almtzr/Pedro/img/kickstarter.png

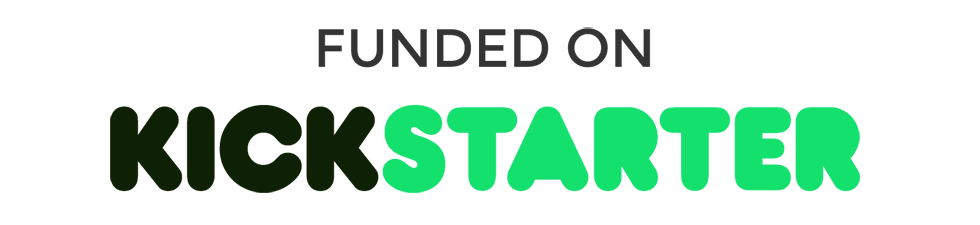
img/kickstarter.png
