almtzr/Pedro/img/pedro_2.03.png

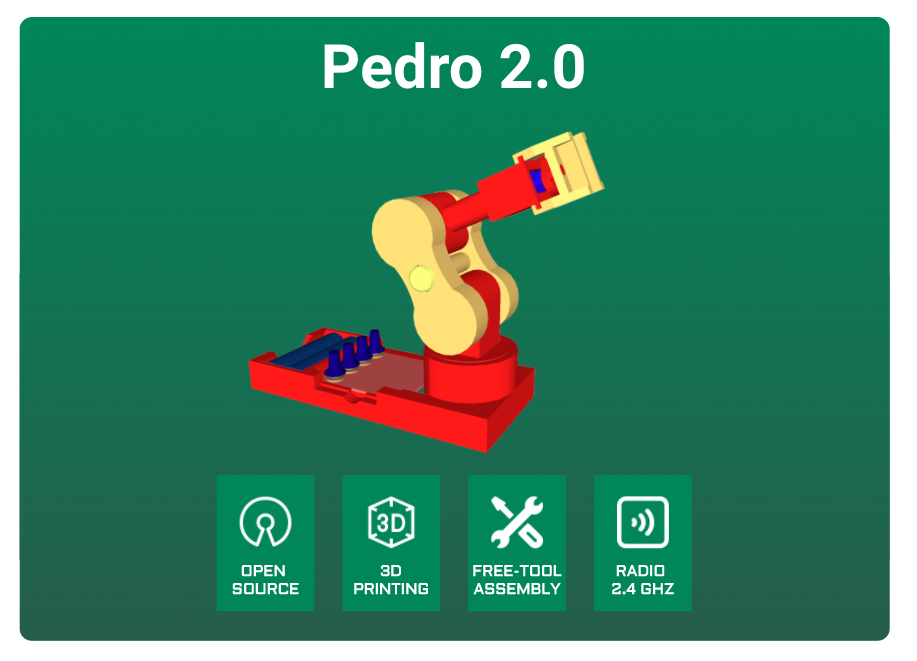
img/pedro_2.03.png
