almtzr/Pedro/img/pedro_kit.png

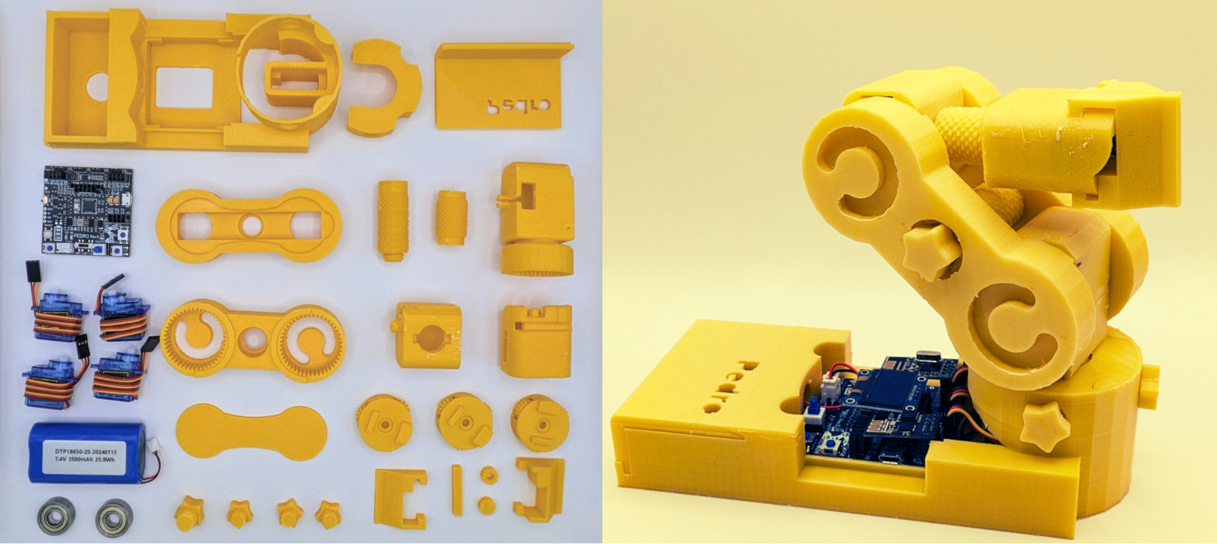
img/pedro_kit.png
