almtzr/Pedro/img/pedro_oshw.png

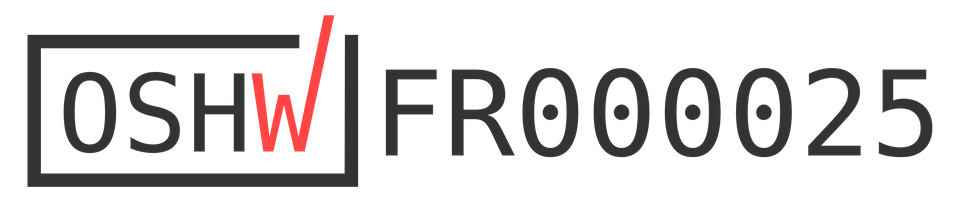
img/pedro_oshw.png
