almtzr/Pedro/img/vote_for_pedro.jpeg

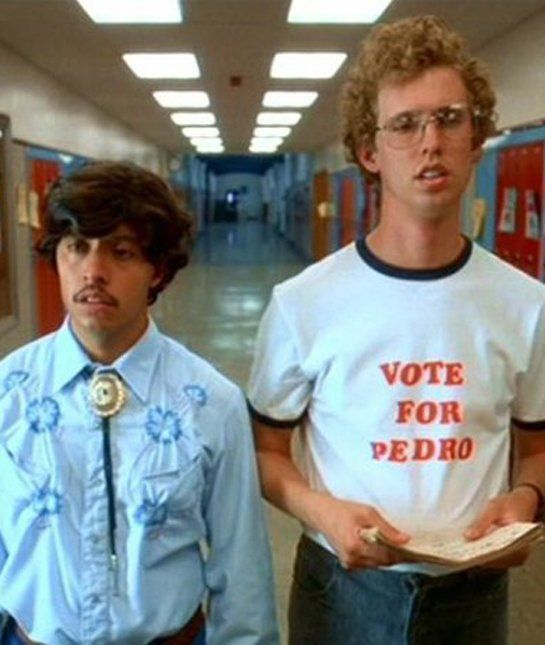
img/vote_for_pedro.jpeg
