almtzr/Pedro/img/workshop.jpg

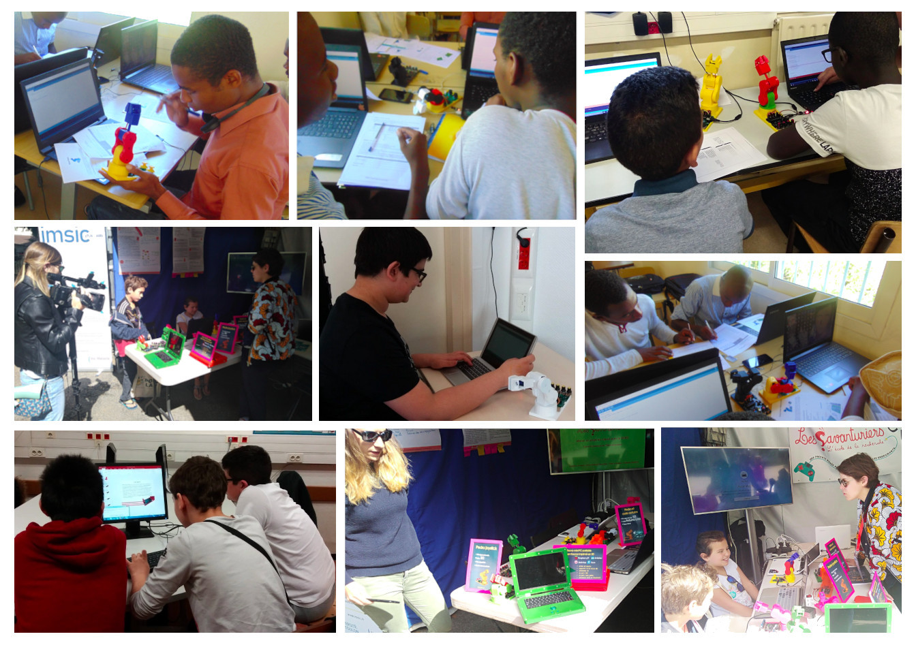
img/workshop.jpg
