almtzr/Pedro/img/wrkp-11.png

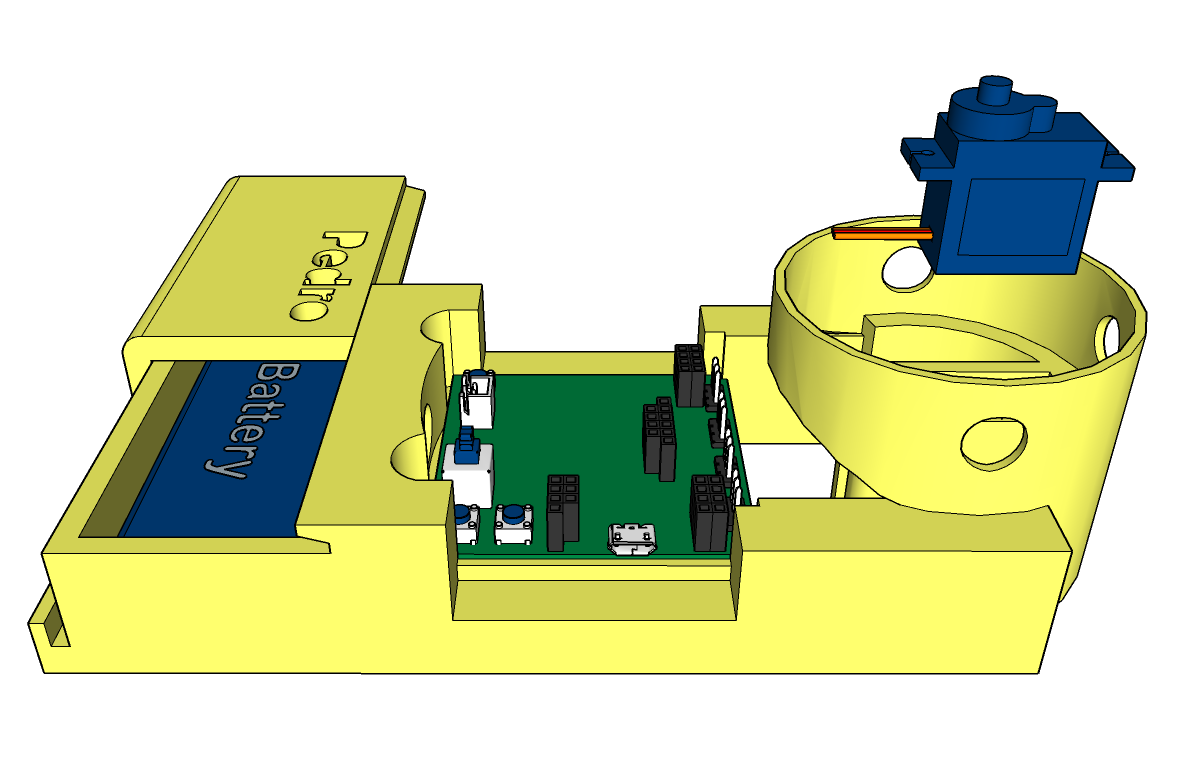
img/wrkp-11.png
