almtzr/Pedro/img/wrkp-12.png

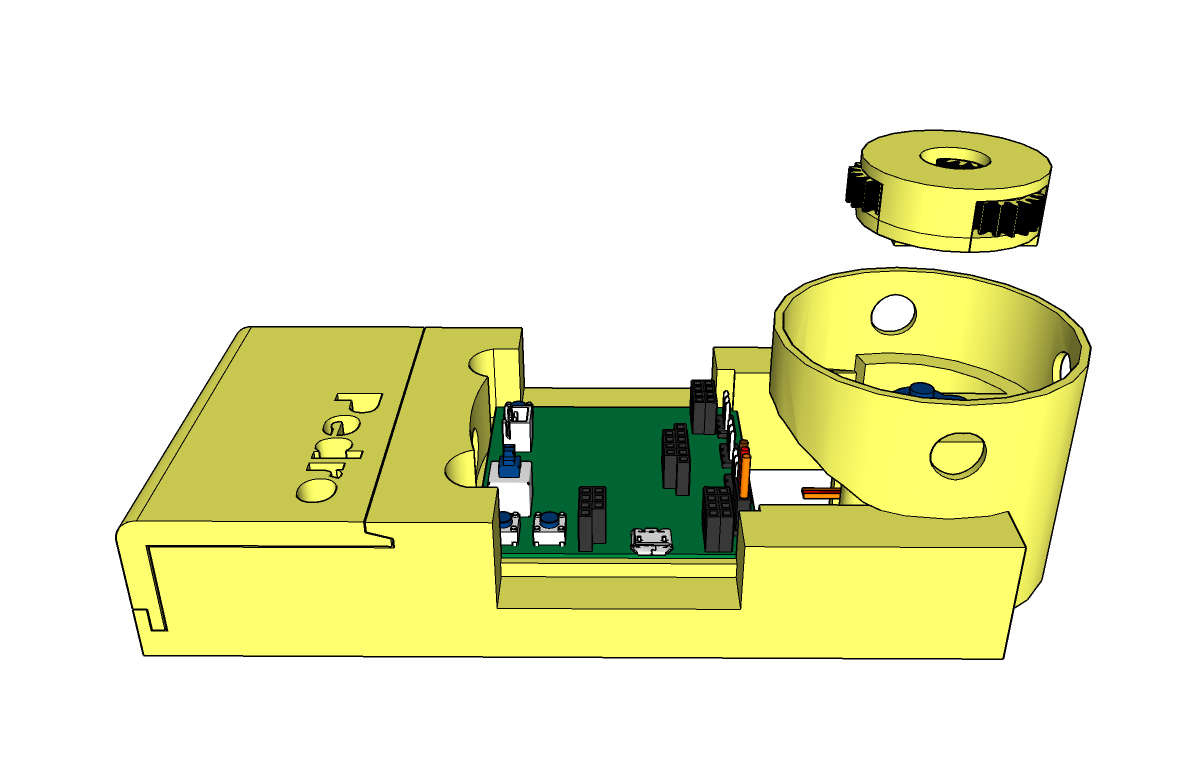
img/wrkp-12.png
