almtzr/Pedro/img/wrkp-13.png

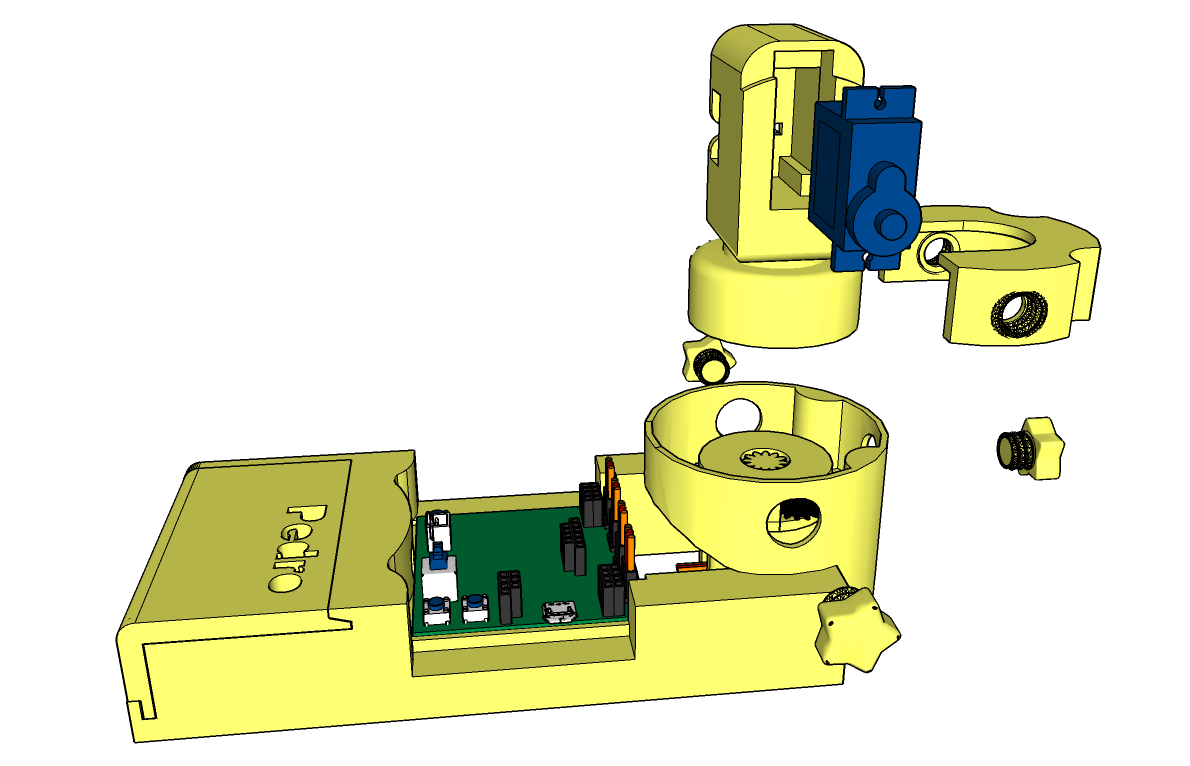
img/wrkp-13.png
