almtzr/Pedro/img/wrkp-14.png

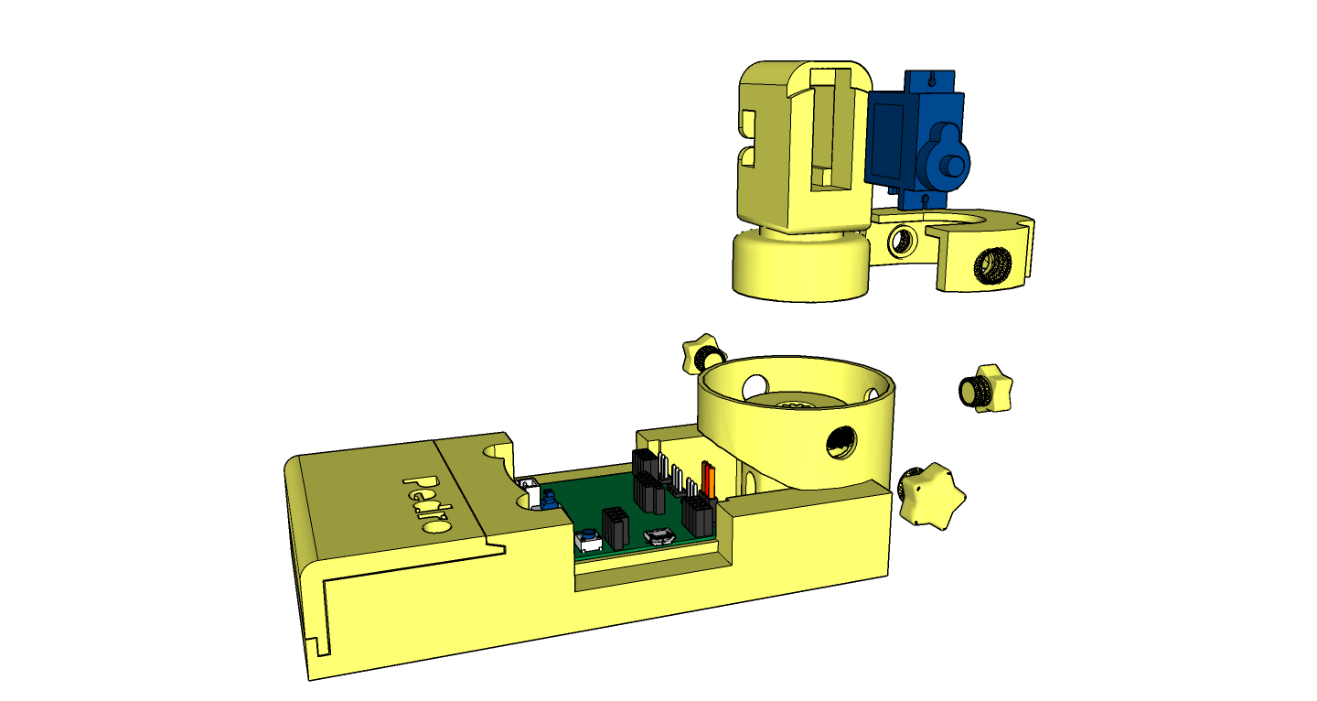
img/wrkp-14.png
