almtzr/Pedro/img/wrkp-15.png

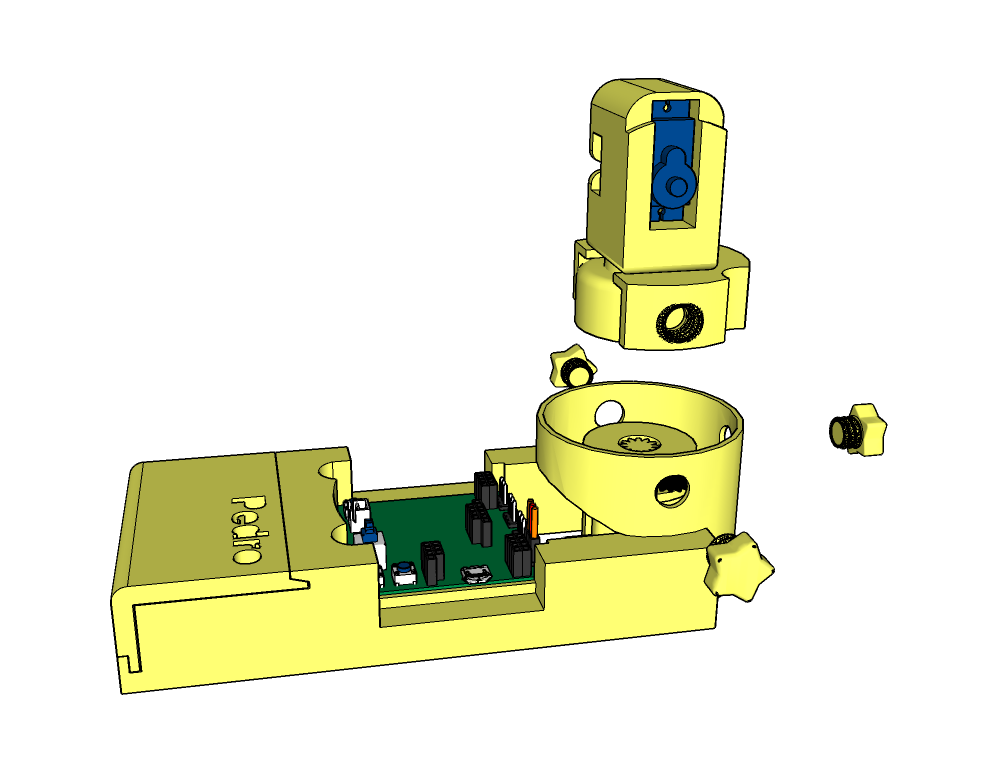
img/wrkp-15.png
