almtzr/Pedro/img/wrkp-16.png

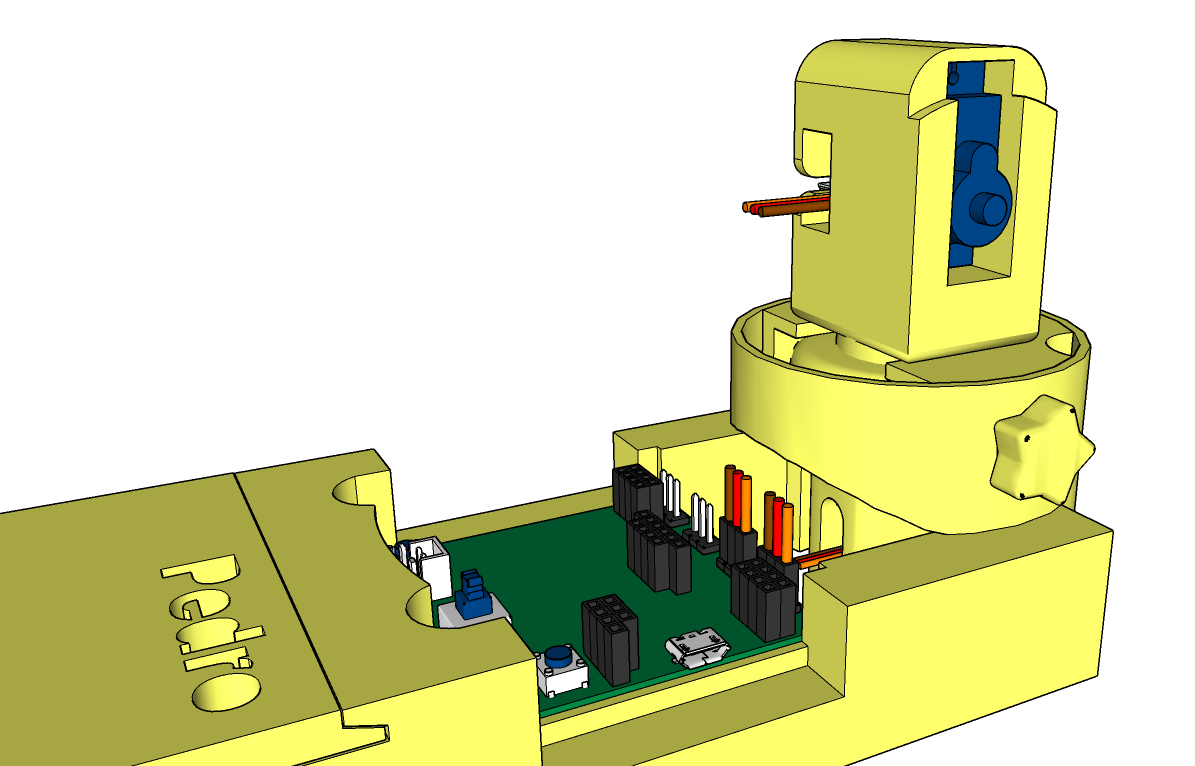
img/wrkp-16.png
