almtzr/Pedro/img/wrkp-21.png

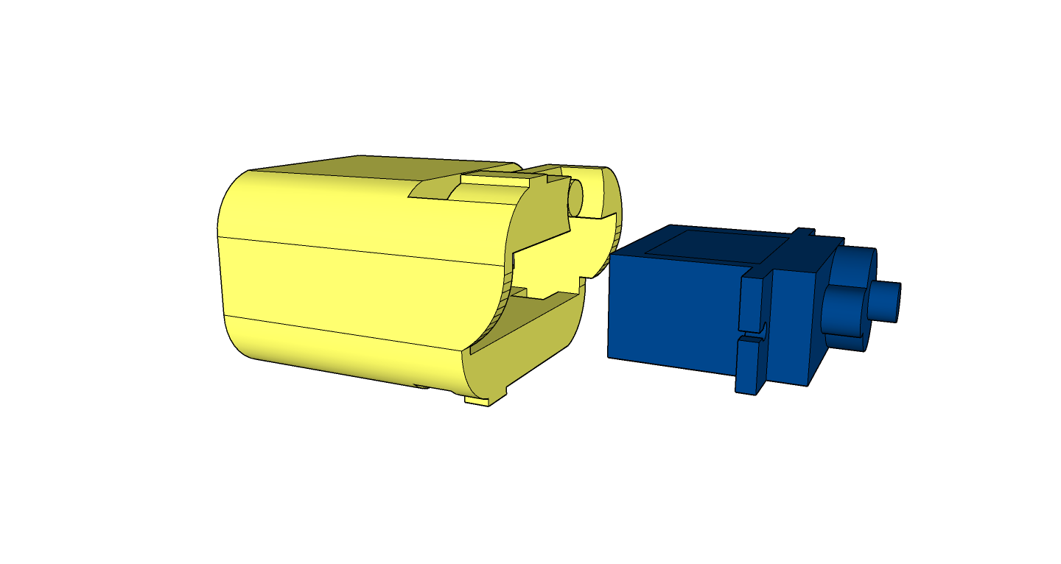
img/wrkp-21.png
