almtzr/Pedro/img/wrkp-22.png

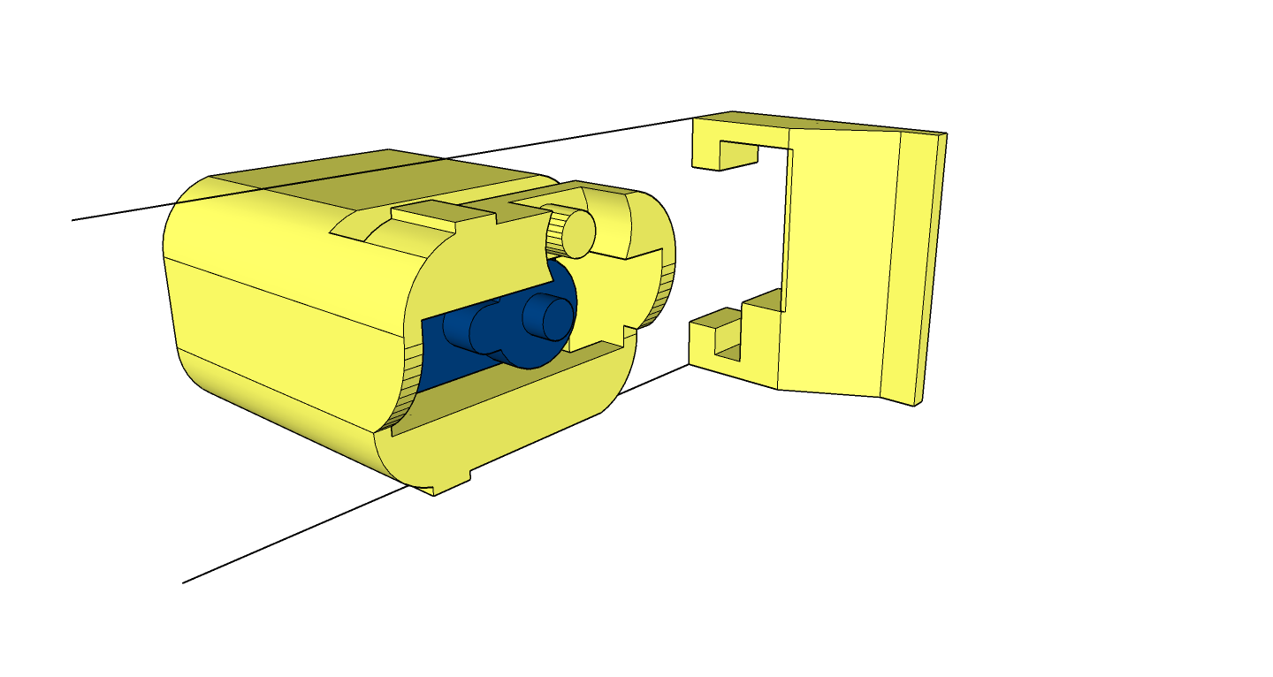
img/wrkp-22.png
