almtzr/Pedro/img/wrkp-23.png

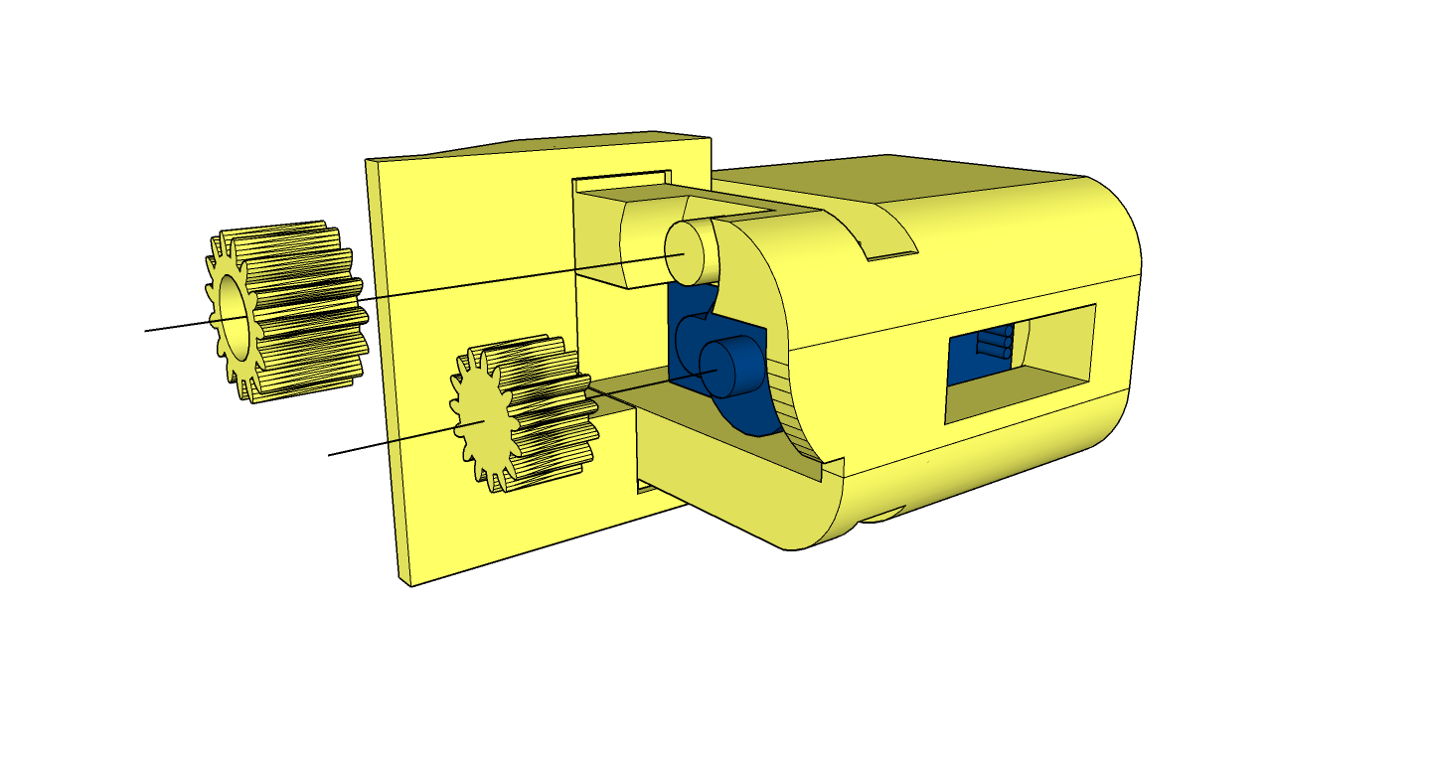
img/wrkp-23.png
