almtzr/Pedro/img/wrkp-24.png

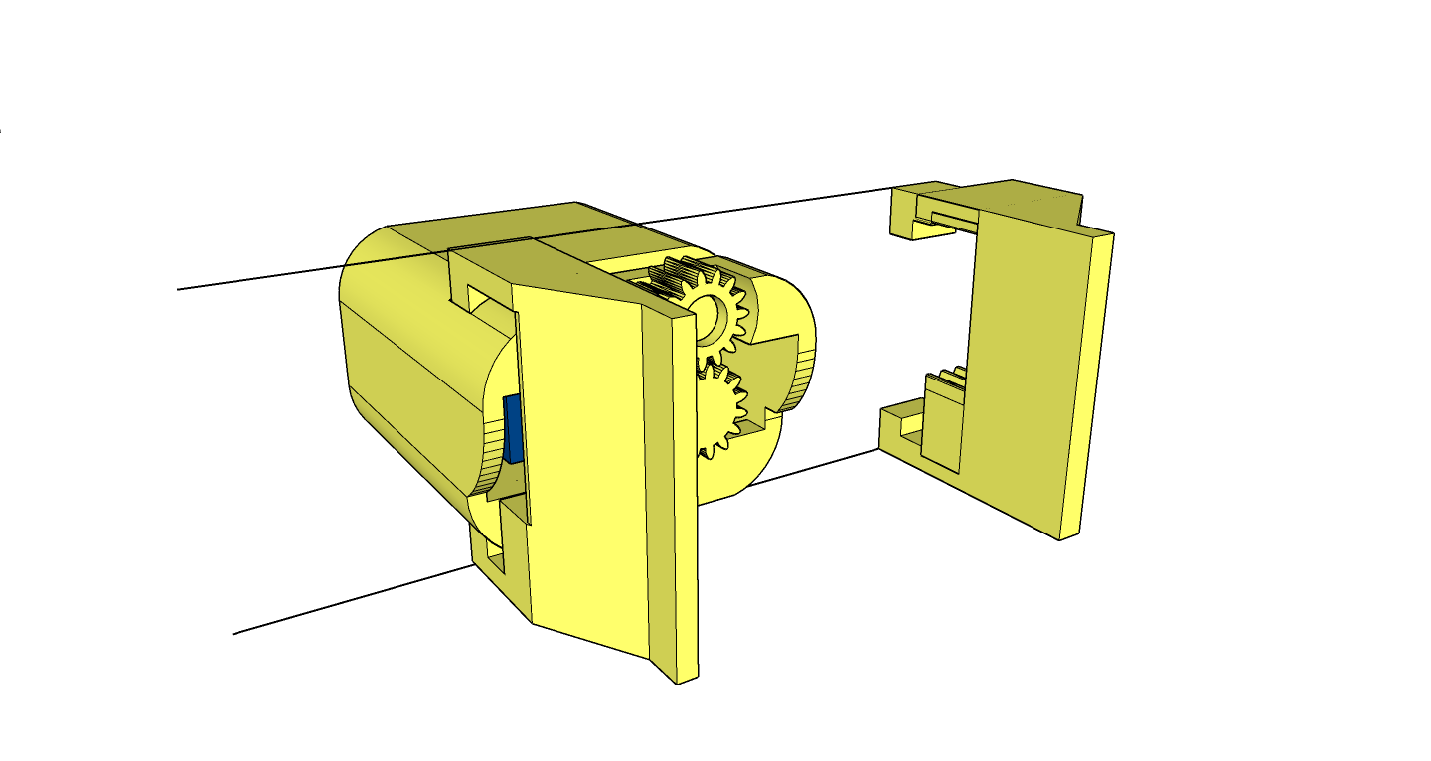
img/wrkp-24.png
