almtzr/Pedro/img/wrkp-25.png

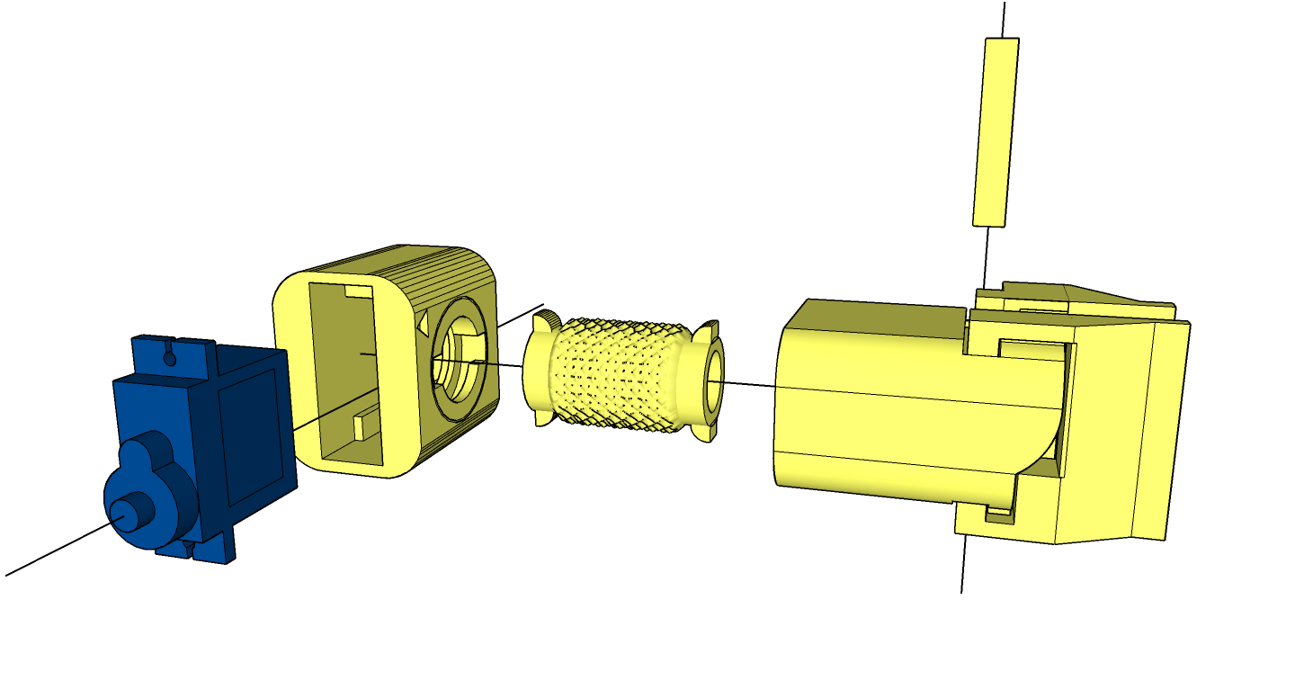
img/wrkp-25.png
