almtzr/Pedro/img/wrkp-26.png

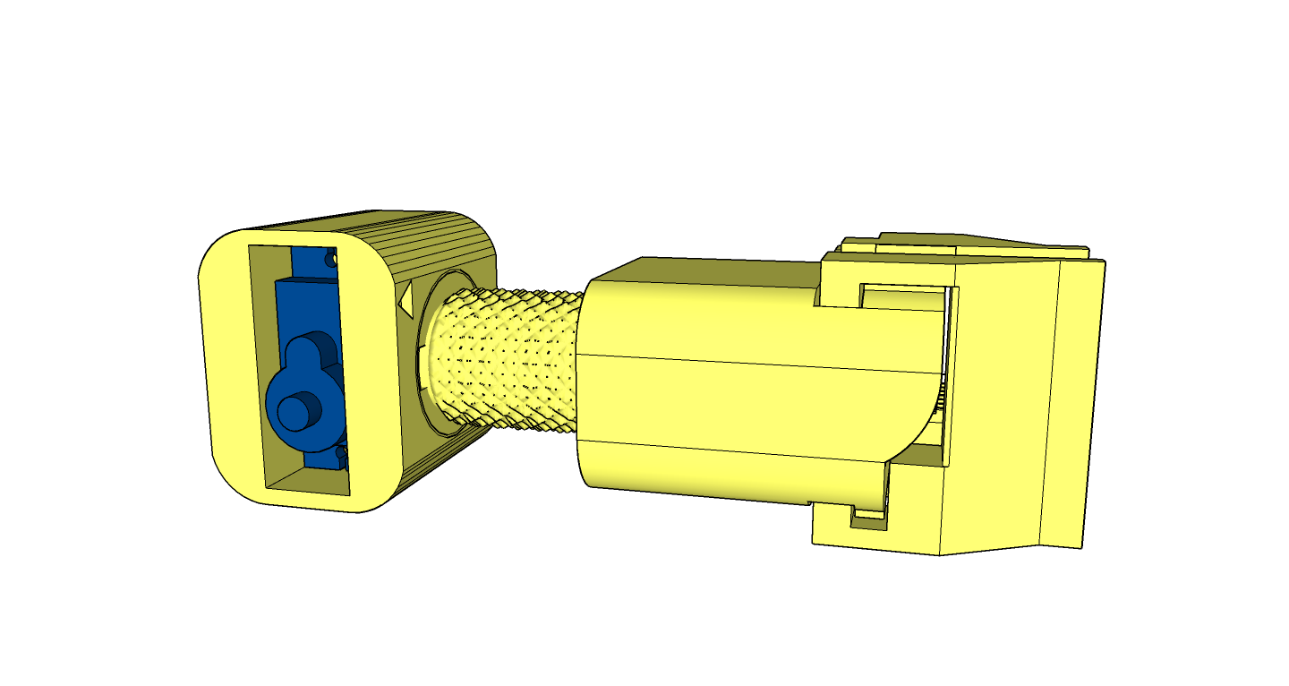
img/wrkp-26.png
