almtzr/Pedro/img/wrkp-27.png

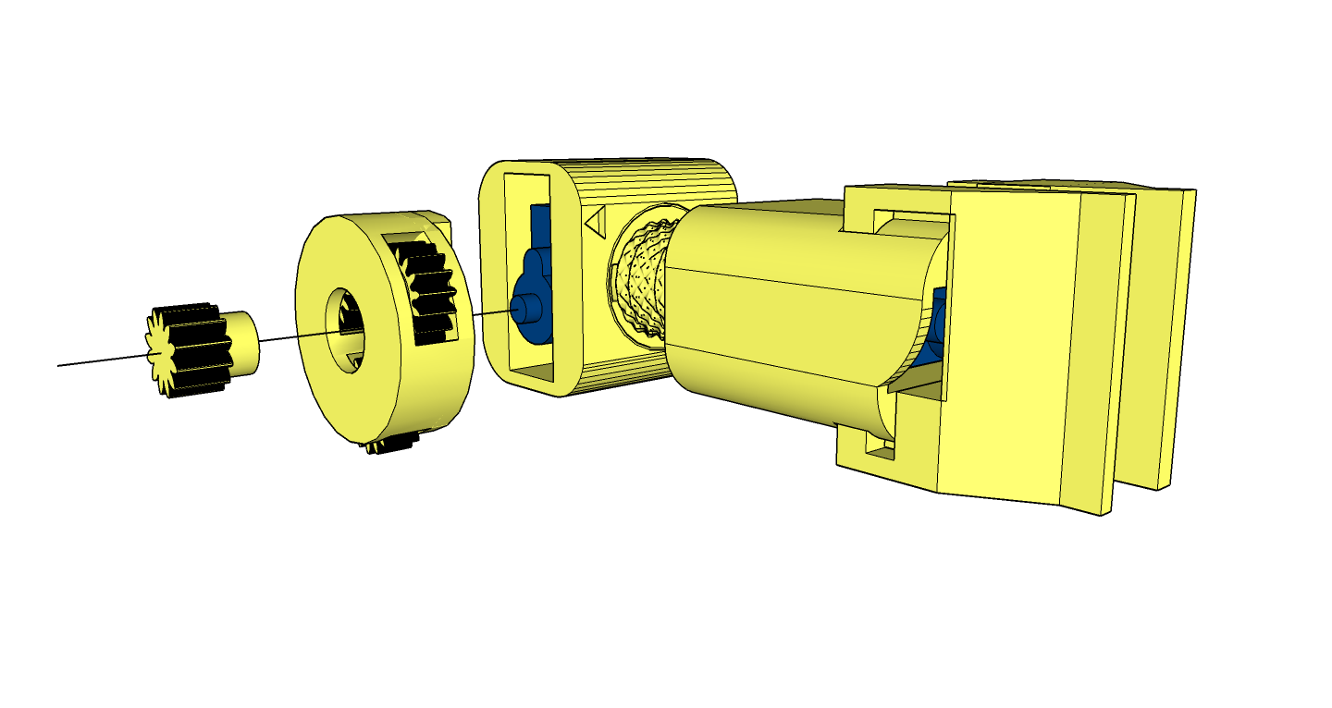
img/wrkp-27.png
