almtzr/Pedro/img/wrkp-28.png

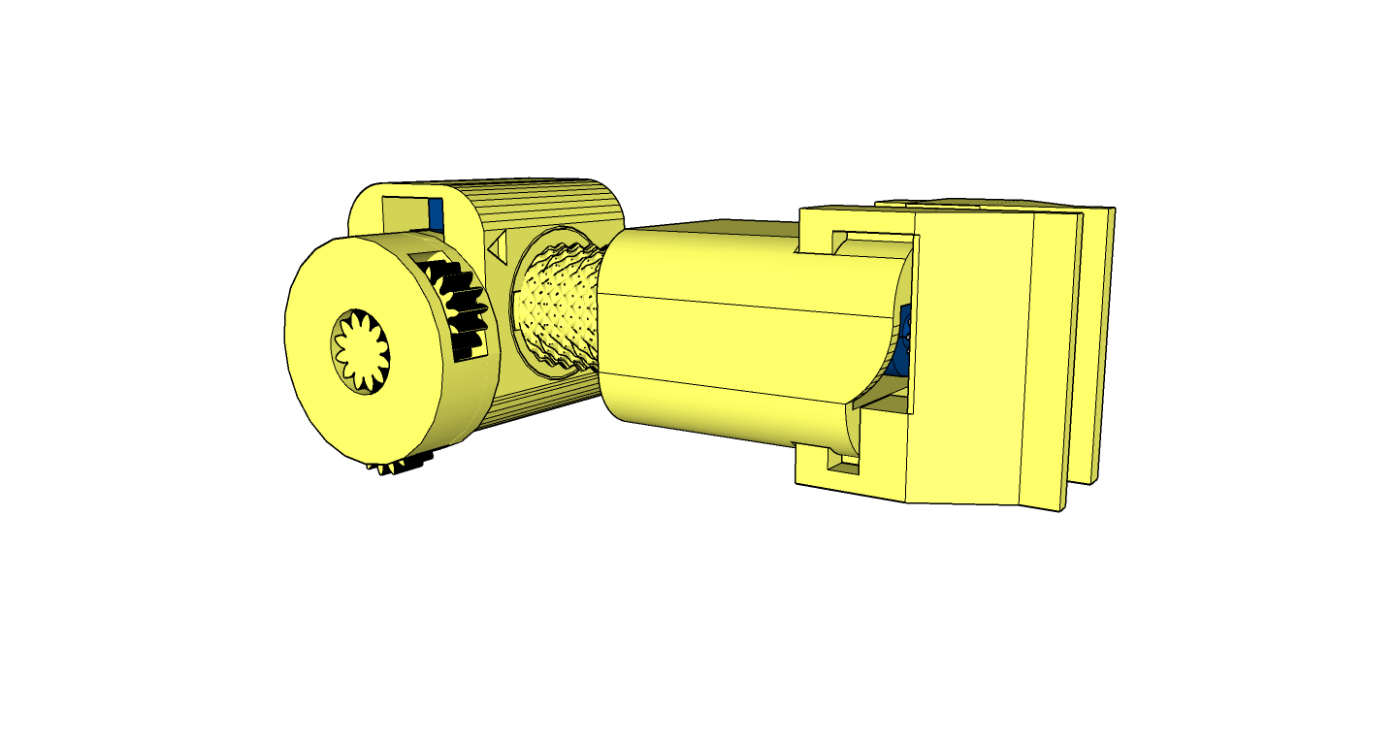
img/wrkp-28.png
