almtzr/Pedro/img/wrkp-31.png

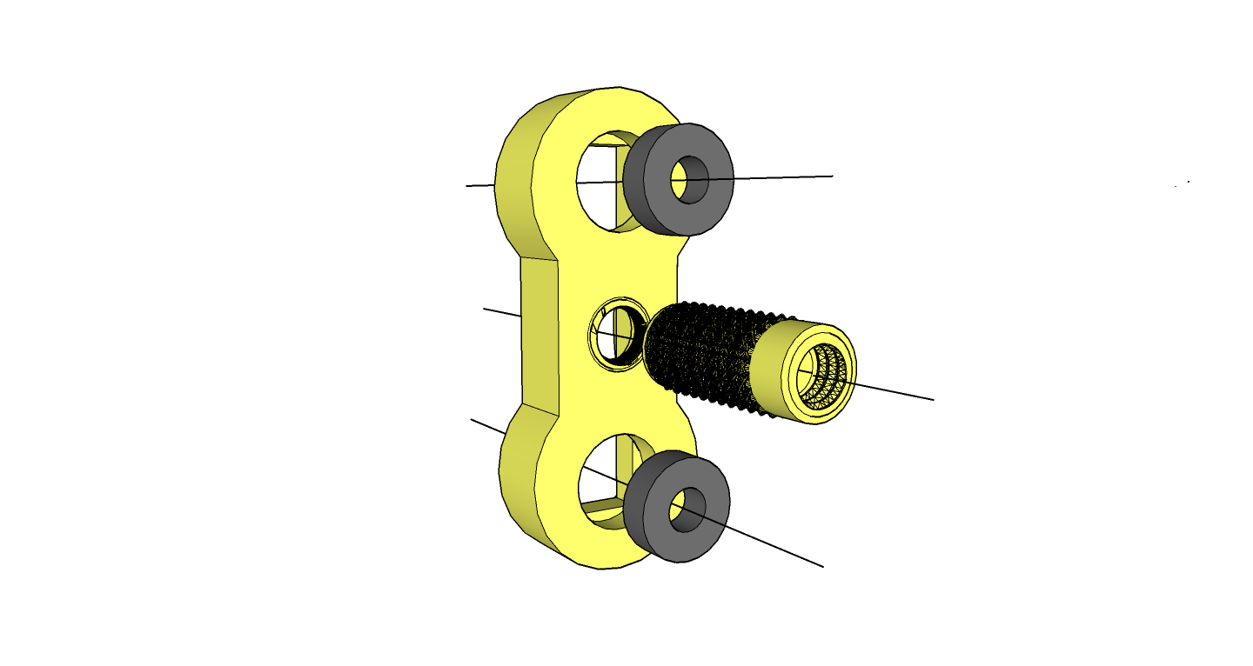
img/wrkp-31.png
