almtzr/Pedro/img/wrkp-32.png

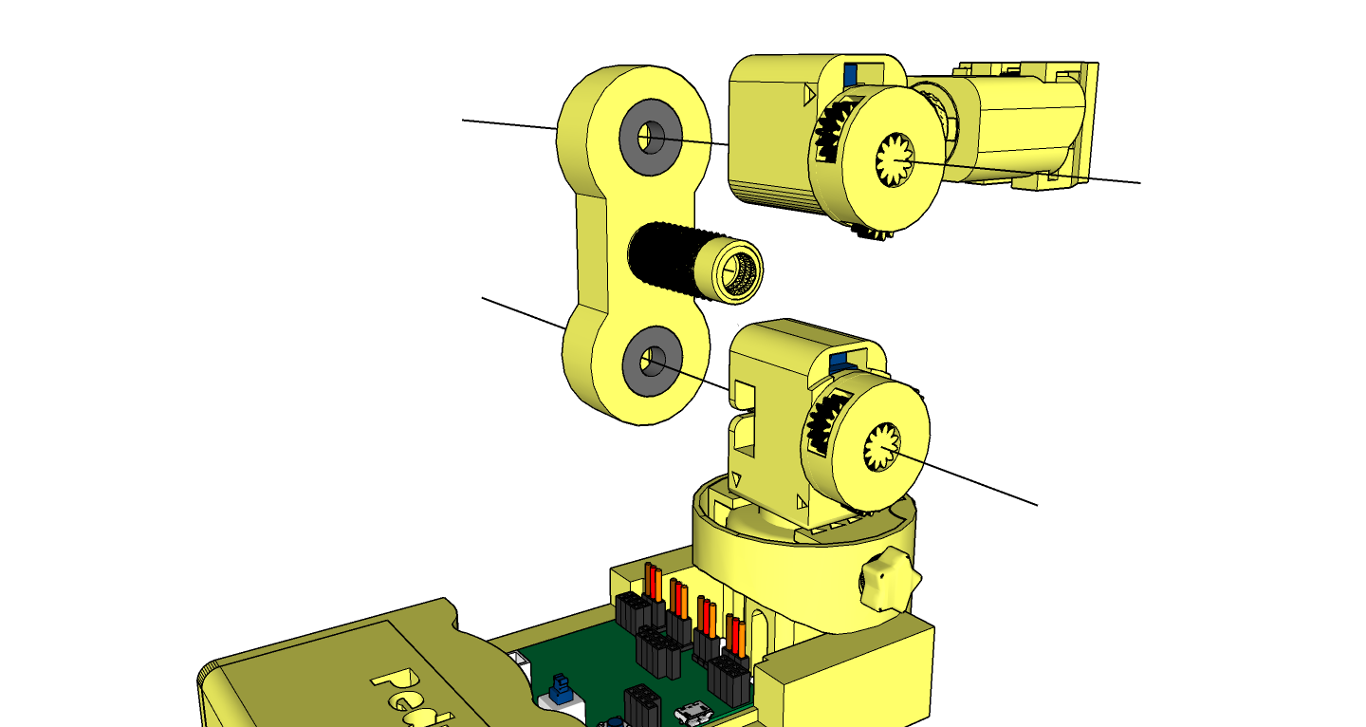
img/wrkp-32.png
