almtzr/Pedro/img/wrkp-33.png

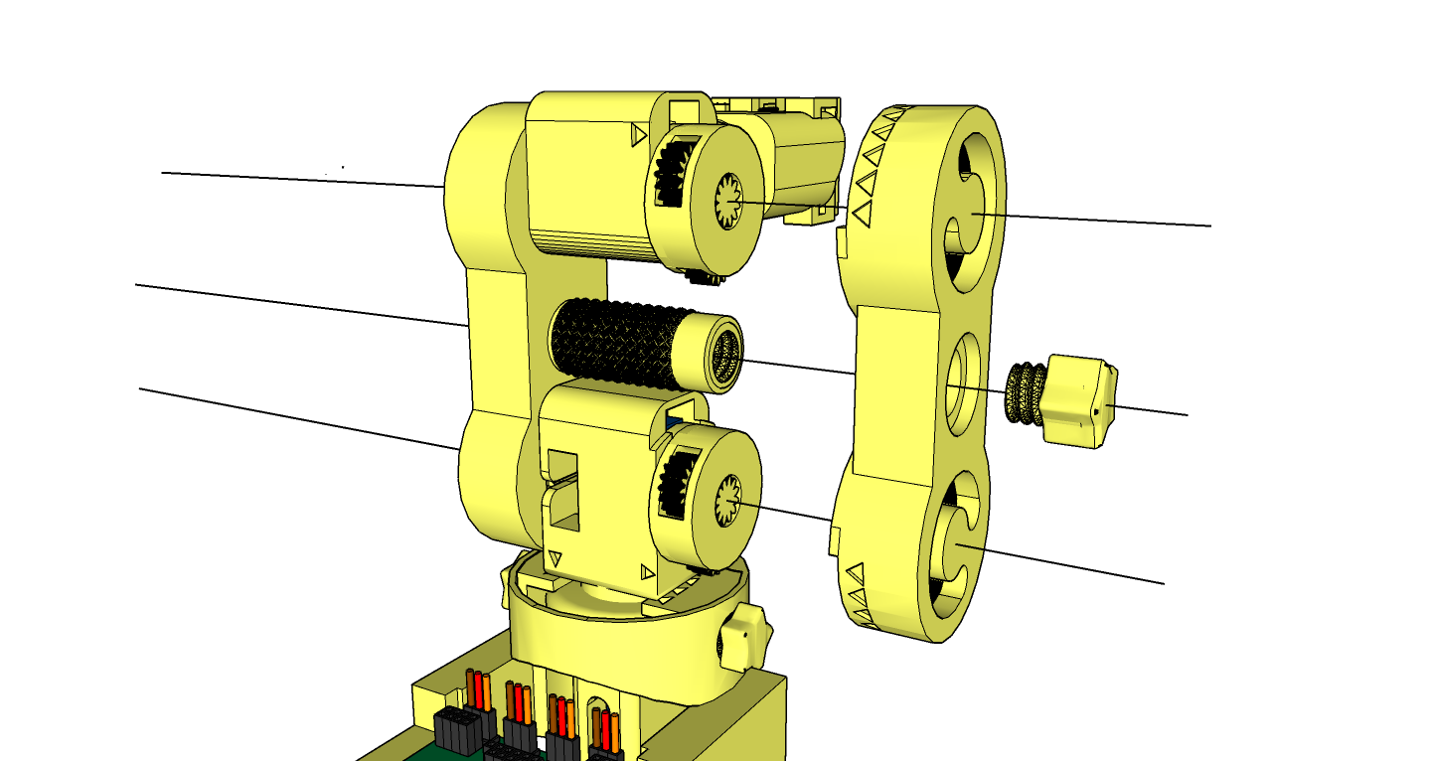
img/wrkp-33.png
