almtzr/Pedro/img/wrkp-34.png

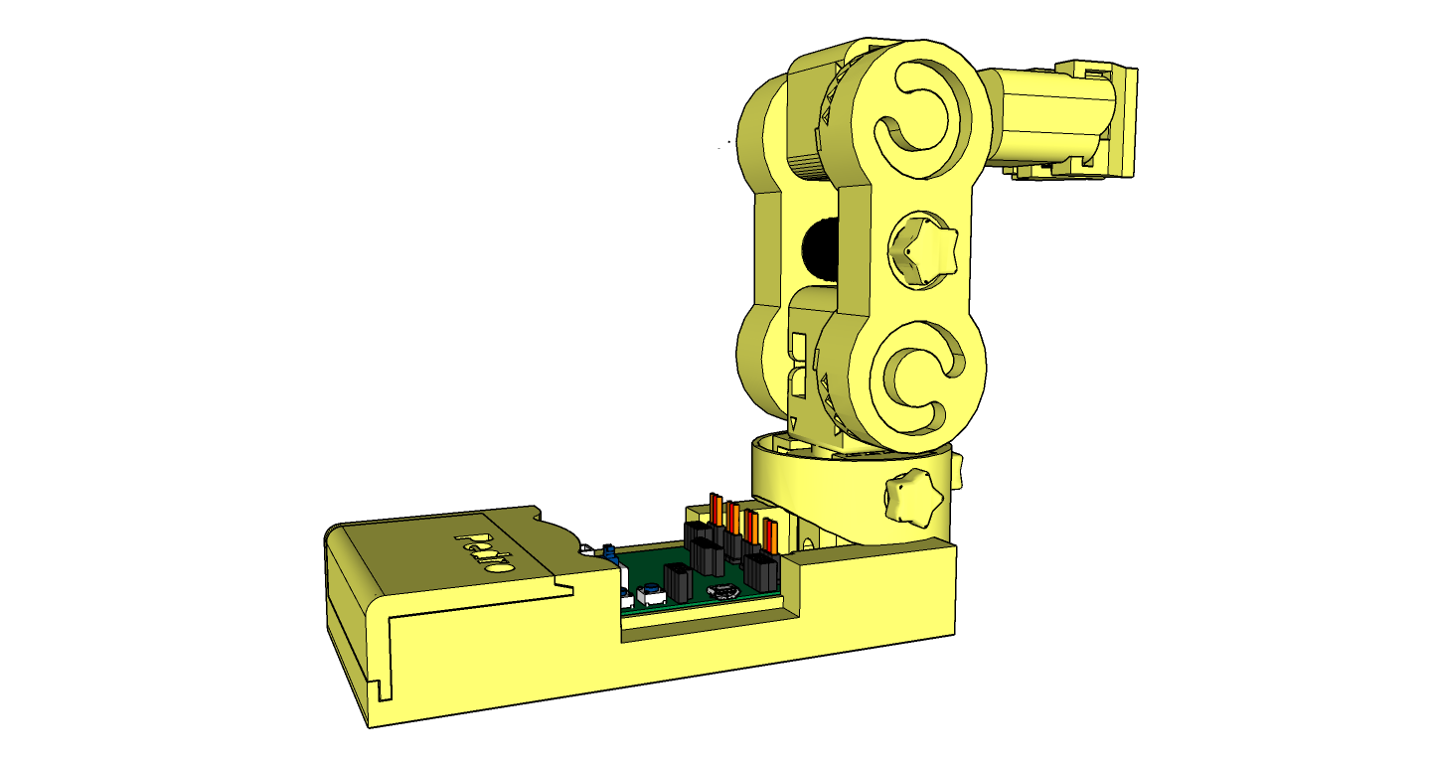
img/wrkp-34.png
