almtzr/Pedro/step/1-base.step

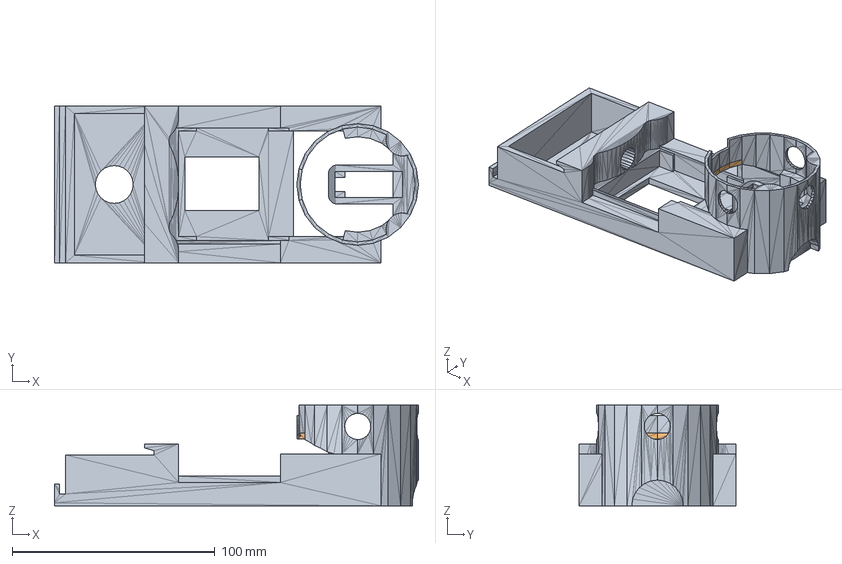
[picture p31: CAD file, 2025-06-10]
step/1-base.step
179.5 x 77.3 x 49.6 mm
