almtzr/Pedro/stl/ARM.stl

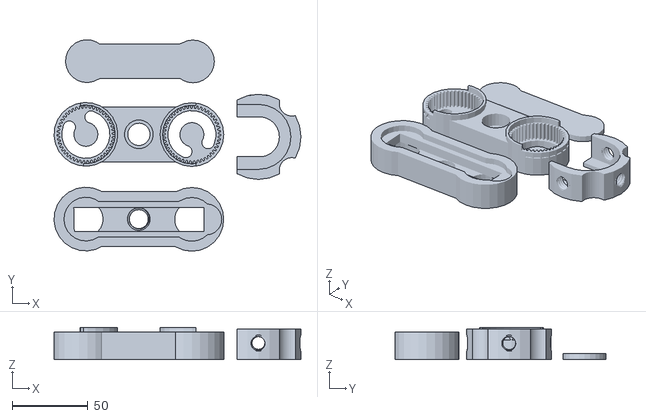
[picture p32: CAD file, 2025-11-19]
stl/ARM.stl
163.0 x 139.6 x 21.1
