almtzr/Pedro/stl/SERVO.stl

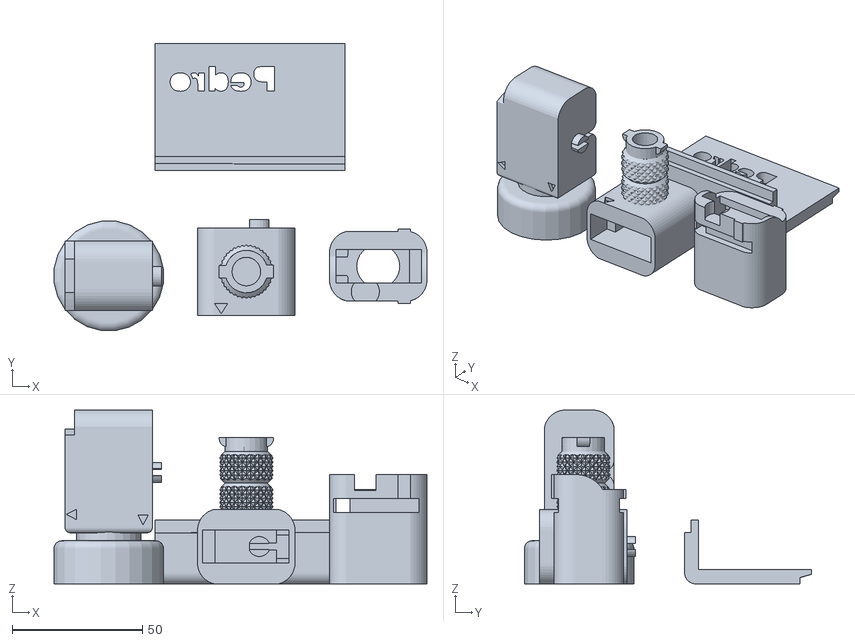
[picture p33: CAD file, 2025-11-19]
stl/SERVO.stl
143.1 x 110.2 x 66.7
