almtzr/Pedro/stl/v2.0/pedro-stl-files-v2.0/SERVO.stl

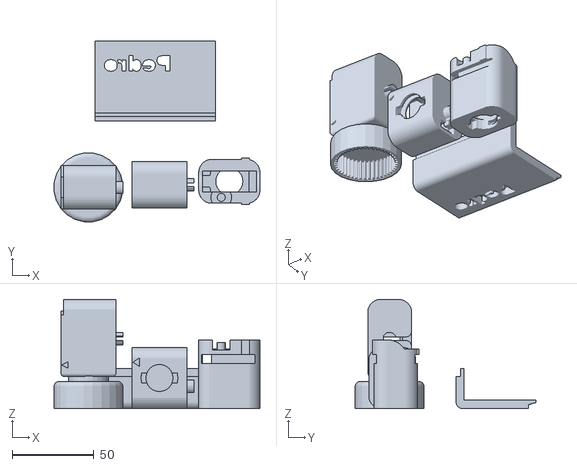
[picture p34: CAD file, 2025-07-19, an earlier design]
stl/v2.0/pedro-stl-files-v2.0/SERVO.stl
125.6 x 110.2 x 66.7
