almtzr/Pedro/stl/v2.1/pedro-stl-files-v2.1/SERVO.stl

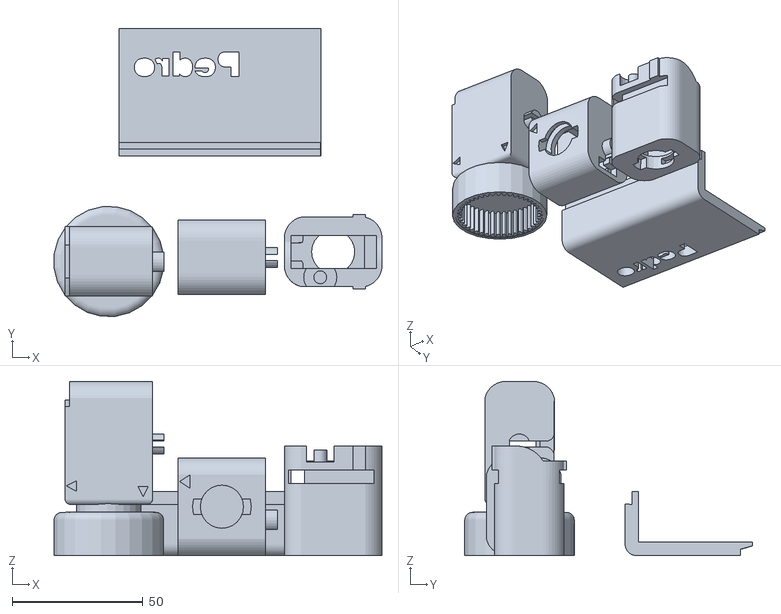
[picture p35: CAD file, 2025-07-31, an earlier design]
stl/v2.1/pedro-stl-files-v2.1/SERVO.stl
125.6 x 110.2 x 66.7
