almtzr/Pedro/stl/v2.1/pedro-stl-files-v2.1/BASE.stl

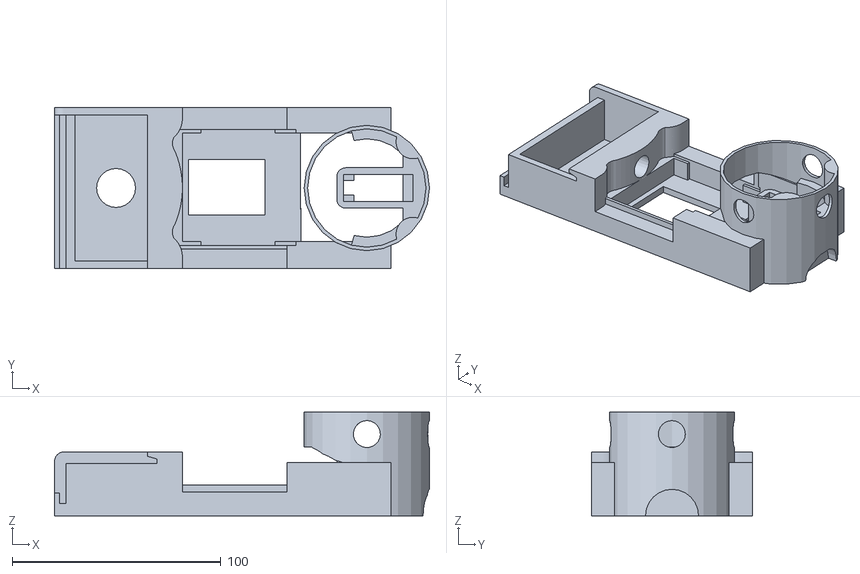
[picture p36: CAD file, 2025-07-19, an earlier design]
stl/v2.1/pedro-stl-files-v2.1/BASE.stl
179.5 x 77.3 x 49.6
