almtzr/Pedro/(list of files, cad)

Other CAD files:
stl/BASE.stl
