almtzr/Pedro/img/print_base.gif

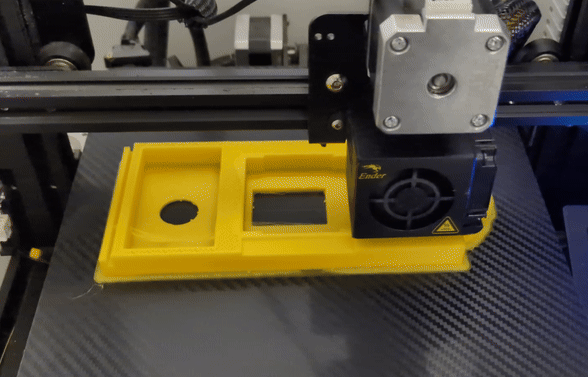
img/print_base.gif
