almtzr/Pedro/stl/CHANGELOG.md

[2.0.2] – 2026-08-17
Modified

Round corners
File: BASE.stl
-------------------------------------------------
[2.0.1] – 2025-11-23
Modified

Reduce the size of the three gear elements for easier assembly.
File: GEAR.stl
-------------------------------------------------
[2.0.0] – 2025-11-19
Added

Initial release of:
ARM.stl, BASE.stl, SERVO.stl, GEAR.stl.
