almtzr/Pedro/(threads)

Thread 3 (2024-11-23):

KiCad or other design file?

andypiper, 2024-11-23:
How can I obtain a Pedro board? Is the Kicad design available for me to order some boards from PCBWay or similar?

almtzr, 2024-11-23:
Hi Andy, the Pedro board is still under development and will be available soon on Kickstarter. Once ready, the Gerber files will be uploaded to Pedro's GitHub page for anyone who wants to create their own.

Closed 2024-11-27.

Thread 9 (2025-04-05):

[issue] PCB Rev2, the GND pin connection to the NRF24L01 module is missing.

almtzr, 2025-04-05:
The GND pin of the NRF24L01 module is not connected to the GND of the board.

**Workaround** if you built the PCB Rev2 from commit : [ae163a6](https://github.com/almtzr/Pedro/commit/ae163a61c12f017fc2ed359325cbb600c3cc568b)

As shown in the picture, you need to solder the NRF module’s GND pin to the servo GND on pin D10.

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

almtzr, 2025-04-14:
Fixed on the Rev2.1 Board by commit [e93ce3](https://github.com/almtzr/Pedro/commit/ee93ce381415ecf3ea9a08e68a34ef1772375964)

Closed 2025-04-14.

Thread 12 (2025-08-26):

What hardware is current

andypiper, 2025-08-26:
My board is marked PEDRO Rev3

I see a schematic here for v2 and gerber for v2.1 and no v3?

Also, the latest STLs appear to be different from the ones used to assemble the Kickstarter Pedro (mine had a broken upper arm, and I had to reprint a part but had to go back to STL v2.0 or 2.1 for the part that fit, it looks like the upper arm assembly is a single piece in the newer models)

It would be really helpful if there was a complete explanation of the current hardware, buttons, etc.

What is the AT/BT slider for? What is the header A3/A4/A5 for?

Thank you.

almtzr, 2025-08-27:
Oh, I see sorry about the broken pieces. Regarding the gripper part, it looks like a slicer issue. It should be sliced as follows; I’m using Cura.

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

I’ve also updated the SERVO.stl in version [v2.3](https://github.com/almtzr/Pedro/tree/main/stl/v2.3/pedro-stl-files-v2.3) to fix this part together with the elbow servo part. Here’s the slicer preview and the printed piece. You could also print this updated part. it’s stronger than the previous version. Hope that helps!

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

Closed 2025-08-29.
