almtzr/Pedro/(commit log)

2025-04-14 Fix Issue #9 on Rev2 board
    [BOM_pedro_rev2.1.csv, PickAndPlace_pedro_rev2.1.csv]
2025-04-25 remove repo
    [base.stl, battery_cover.stl, elbow_shoulder_gripper.stl, gripper_tools.stl]
2025-04-25 update files
    [1-base.stl, 10-gripper.stl, 11-gripper_tools.stl, 2-battery_cover.stl, 9-shoulder.stl]
2025-04-27 updated files
    [11-gripper_tools.stl, 12-gripper_gear.stl, 9-shoulder.stl]
2025-05-12 update pedro board image
2025-05-13 update elbow file
    [4-elbow.stl]
2025-05-16 update gear
    [12-gripper_gear.stl]
2025-06-08 update planetary gear systems
2025-06-10 add step base
    [1-base.step]
2025-07-19 STL files v2.0
    [1-base.stl, 10-gripper.stl, 11-gripper_tools.stl, 12-gripper_gear.stl, 2-battery_cover.stl, 3-support.stl, 4-elbow.stl, 9-shoulder.stl]
2025-07-31 STL files v2.1
    [BASE.stl, SERVO.stl]
2025-08-16 STL files v2.2
    [ARM.stl, BASE.stl, SERVO.stl]
2025-08-21 Fix v2.2 STL file issue #11
    [ARM.stl]
2025-08-26 update stl v2.3
    [ARM.stl, BASE.stl, SERVO.stl]
2025-09-01 STL file v2.4
    [ARM.stl, BASE.stl, SERVO.stl]
2025-09-15 STL file v2.5
    [ARM.stl, BASE.stl, SERVO.stl]
2025-09-30 Update Pedro
    [BOM_pedro_rev2.1.csv, PickAndPlace_pedro_rev2.1.csv]
2025-10-07 update stl v2.6
    [ARM.stl, BASE.stl, SERVO.stl]
2025-10-14 stl v2.6
    [ARM.stl, BASE.stl, SERVO.stl]
2025-11-02 update stl v2.7
    [ARM.stl, BASE.stl, SERVO.stl]
2025-11-19 Added files v2.0.0
    [ARM.stl, BASE.stl, SERVO.stl]
2026-08-17 round corners BASE.stl
    [BASE.stl]
